JasonHEngineering/BLDC-driver-DRV8316-MT6835/README.md

# BLDC-driver-DRV8316-MT6835
Custom PCBA build BLDC driver based on DRV8316 and absolute encoder MT6835

WordPress:
https://jashuang1983.wordpress.com/custom-pcba-bldc-driver-esp32-c6-mini-drv8316-mt6835-sh65hvd/

YouTube:
https://youtu.be/7OfQm1vRN5s

Singled-sided PCBA design (larger, but would be more economical) - fabricated:





Double-sided PCBA design (smaller, but would be more expensive):
