JasonHEngineering/BLDC-driver-DRV8316-MT6835/BLDC_DRV8313_AS5048A_modular_trial/README.md

# Modular Trial DRV8313 + AS5048A 

Initial BLDC (GB2806) run based on DRV83163 module and absolute encoder AS5048A

Actual setup:



Equivalent setup:
