JasonHEngineering/BLDC-driver-DRV8316-MT6835/BLDC_DRV8316_MT6835_custom_board_double_side (not fabricated)/Production files/bom.csv

Designator | Footprint | Quantity | Value | LCSC Part #
C1, C9 | C1210 | 2 | 22uF ±10% 35V X5R 1210 | C6120016
C10, C11, C12 | C0402 | 3 | 1nF ±10% 50V X7R 0402 | C14442
C14 | C0402 | 1 | 10uF 6.3V X5R 0402 | C412251
C2, C26, C3, C32, C4, C5, C6, C7 | C0402 | 8 | 100nF ±10% 50V | C307331
C22, C28, C29, C8 | C0603 | 4 | 1uF ±10% 50V | C5199872
C23 | C0603 | 1 | 47nF ±10% 50V | C107093
C24 | CAP-SMD_BD5.0-L5.3-W5.3-LS6.0-FD-H5.4 | 1 | ±20% 35V 10uF SMD,D5xL4.5mm | C51953405
C25 | C0603 | 1 | 22uF ±20% 16V X5R 0603 | C2762594
D1, D2 | SOD-323_L1.8-W1.3-LS2.5-RD | 2 | CUS10S30,H3F | C146335
D3 | DFN1006-2L-BI | 1 | TPD1E10B06DPYR_C2937015 | C2937015
L2 | IND-SMD_L2.5-W2.0 | 1 | 10uH | C5832376
R1, R6 | R0402 | 2 | 100kΩ 62.5mW 50V | C60491
R10, R2, R3 | R0402 | 3 | 50V 62.5mW 100Ω ±1% 0402 | C106232
R11, R12, R15, R21, R22, R23, R24, R26 | R0402 | 8 | 62.5mW 50V ±1% 10kΩ 0402 | C60490
R13, R9 | R0402 | 2 | 5.1kΩ 62.5mW 50V | C105872
R16, R17, R18, R19, R27, R5 | R0402 | 6 | 62.5mW_50V_±1%_33Ω_0402 | C138002
R20 | R0402 | 1 | 120Ω 62.5mW 50V | C114758
R25 | R0805 | 1 | 125mW 22Ω ±1% 0805 | C107702
R4 | R0402 | 1 | 470Ω ±1% 62.5mW 0402 | C25117
R7 | R0805 | 1 | 19kΩ ±1% 125mW 0805 | C2930177
SW2, SW3 | SW-SMD_L3.9-W3.0-P4.45 | 2 | TS-1088-AR02016 | C720477
U1 | LED0603-R-RD | 1 | XL-1608UBC-06A | C7371904
U10 | WIFIM-SMD_61P-L16.6-W13.2-P0.80-ESP32-C6-MINI-1-N4 | 1 | ESP32-C6-MINI-1-H4 | C6553337
U11 | SOT-23-6_L2.9-W1.6-P0.95-LS2.8-BL | 1 | TP6841S6-A | C2844924
U2 | SOIC-8_L4.9-W3.9-P1.27-LS6.0-BL | 1 | SN65HVD230DR | C12084
U3 | SOT-23-6 | 1 | USBLC6-2SC6 | C7519
U4 | SOT-23-5_L2.9-W1.6-P0.95-LS2.8-BL | 1 | TLV75733PDBVR | C485517
U5 | TSSOP-16_L5.0-W4.4-P0.65-LS6.4-BL | 1 | MT6835GT-STD | C2932578
U7 | VQFN-40_L7.0-W5.0-P0.50-BL-EP5.7 | 1 | DRV8316CRRGFR | C5447274
U8, U9 | CONN-SMD_4P-P1.00_MEGASTAR_ZX-SH1.0-4PWT | 2 | ZX-SH1.0-4PWT | C7430446
USB2 | USB-TYPE-C-SMD_TYPE-C-16P-QTWT | 1 | TYPE-C 16P QTWT | C5187472
