JasonHEngineering/BLDC-driver-DRV8316-MT6835/BLDC_DRV8316_MT6835_custom_board_single_side (fabricated and tested)/README.md

# BLDC driver DRV8316, MT6835

Custom PCBA build BLDC driver based on DRV8316 and absolute encoder MT6835, which allows for driving a BLDC already. There is also a CAN transceiver SN65HVD230DR on board for conducting CAN communication.

Design notes for improvement:

1) The schematic would show that the MT6835 Vdd is connected to 5V. This is not healthy for SPI bus that are 3v3 intended. While in general the devices are working for now, I would need to note this in future iterations - Vdd should be powered with 3v3.

This is a slightly bigger version that was actually fabricated is also more economical due to 1-sided SMD assembly:



Soldering on 2 cables; 1 for the main power supply 8-24 V, and the other for the 3 phase BLDC 



Board with BLDC GB2806 mounted, along with a 6 mm diametric magnet mounted directly on motor shaft for position feedback 



The magnet is on the opposite of the MT6835 absolute encoder package, and is about 1 mm above the PCBA



3 boards connected over CAN bus. 2 of these boards have solder bridge (jumper) for CAN termination. 
