JasonHEngineering/BLDC-driver-DRV8316-MT6835/BLDC_DRV8316_MT6835_custom_board_double_side (not fabricated)/README.md

# BLDC driver DRV8316, MT6835

Custom PCBA build BLDC driver based on DRV8316 and absolute encoder MT6835

This is a double sided assembly version that is smaller than the single sided version:
