JasonHEngineering/BLDC-driver-DRV8316-MT6835/BLDC_DRV8316_MT6835_custom_board_single_side (fabricated and tested)/Test codes/CAN - Simple CAN transmitter and reciever pair/CAN message in Serial.png

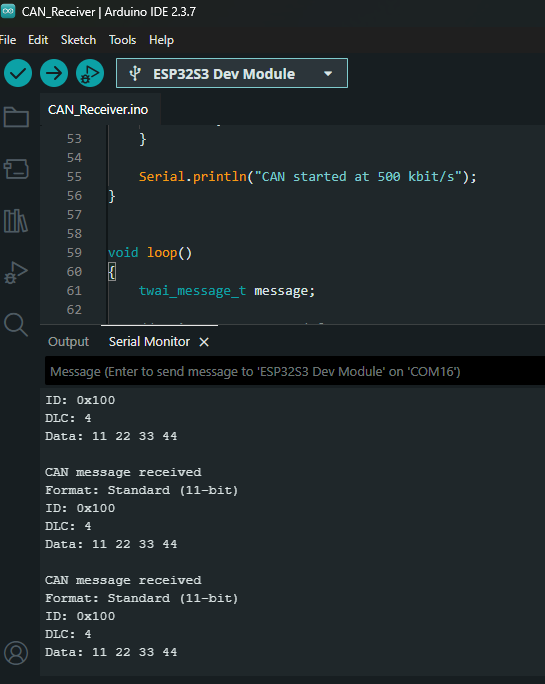
BLDC_DRV8316_MT6835_custom_board_single_side (fabricated and tested)/Test codes/CAN - Simple CAN transmitter and reciever pair/CAN message in Serial.png
