JasonHEngineering/BLDC-driver-DRV8316-MT6835/BLDC_DRV8316_MT6835_custom_board_double_side (not fabricated)/Schematic/ESP32-C6_DRV8316_MT6835_CAN_V1.pdf

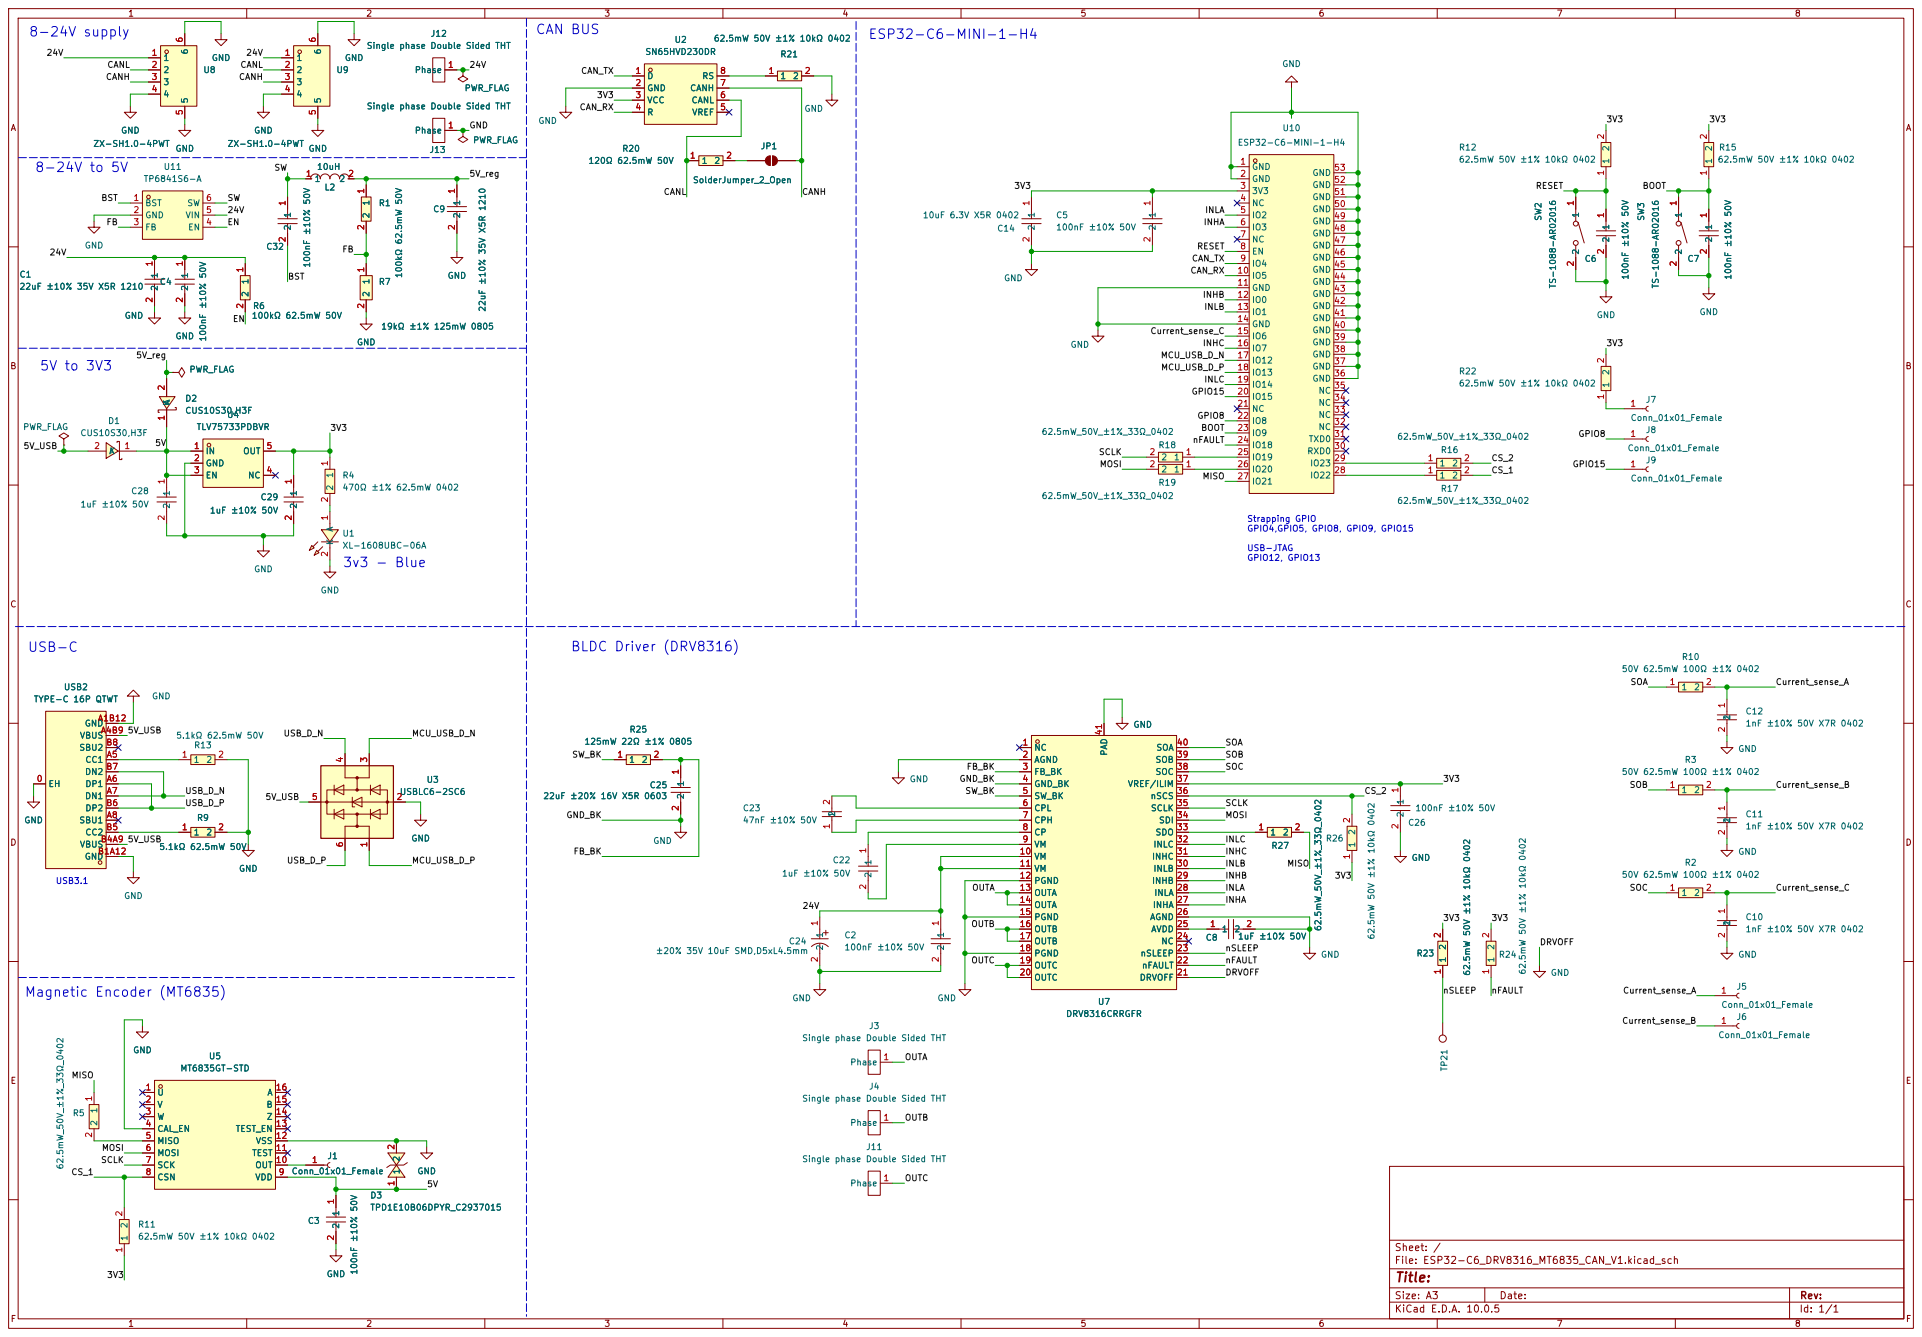
[picture p2: page 1]

Single phase Double Sided THT PWR_FLAG

Single phase Double Sided THT 1

Single phase Double Sided THT GND

OUTA

Single phase Double Sided THT

Size: A3 | Rev: | F Date:
KiCad E.D.A. 10.0.5 | Id: 1/1
