JasonHEngineering/BLDC-driver-DRV8316-MT6835/BLDC_DRV8316_MT6835_custom_board_single_side (fabricated and tested)/Schematic/ESP32-C6_DRV8316_MT6835_CAN_V2.pdf

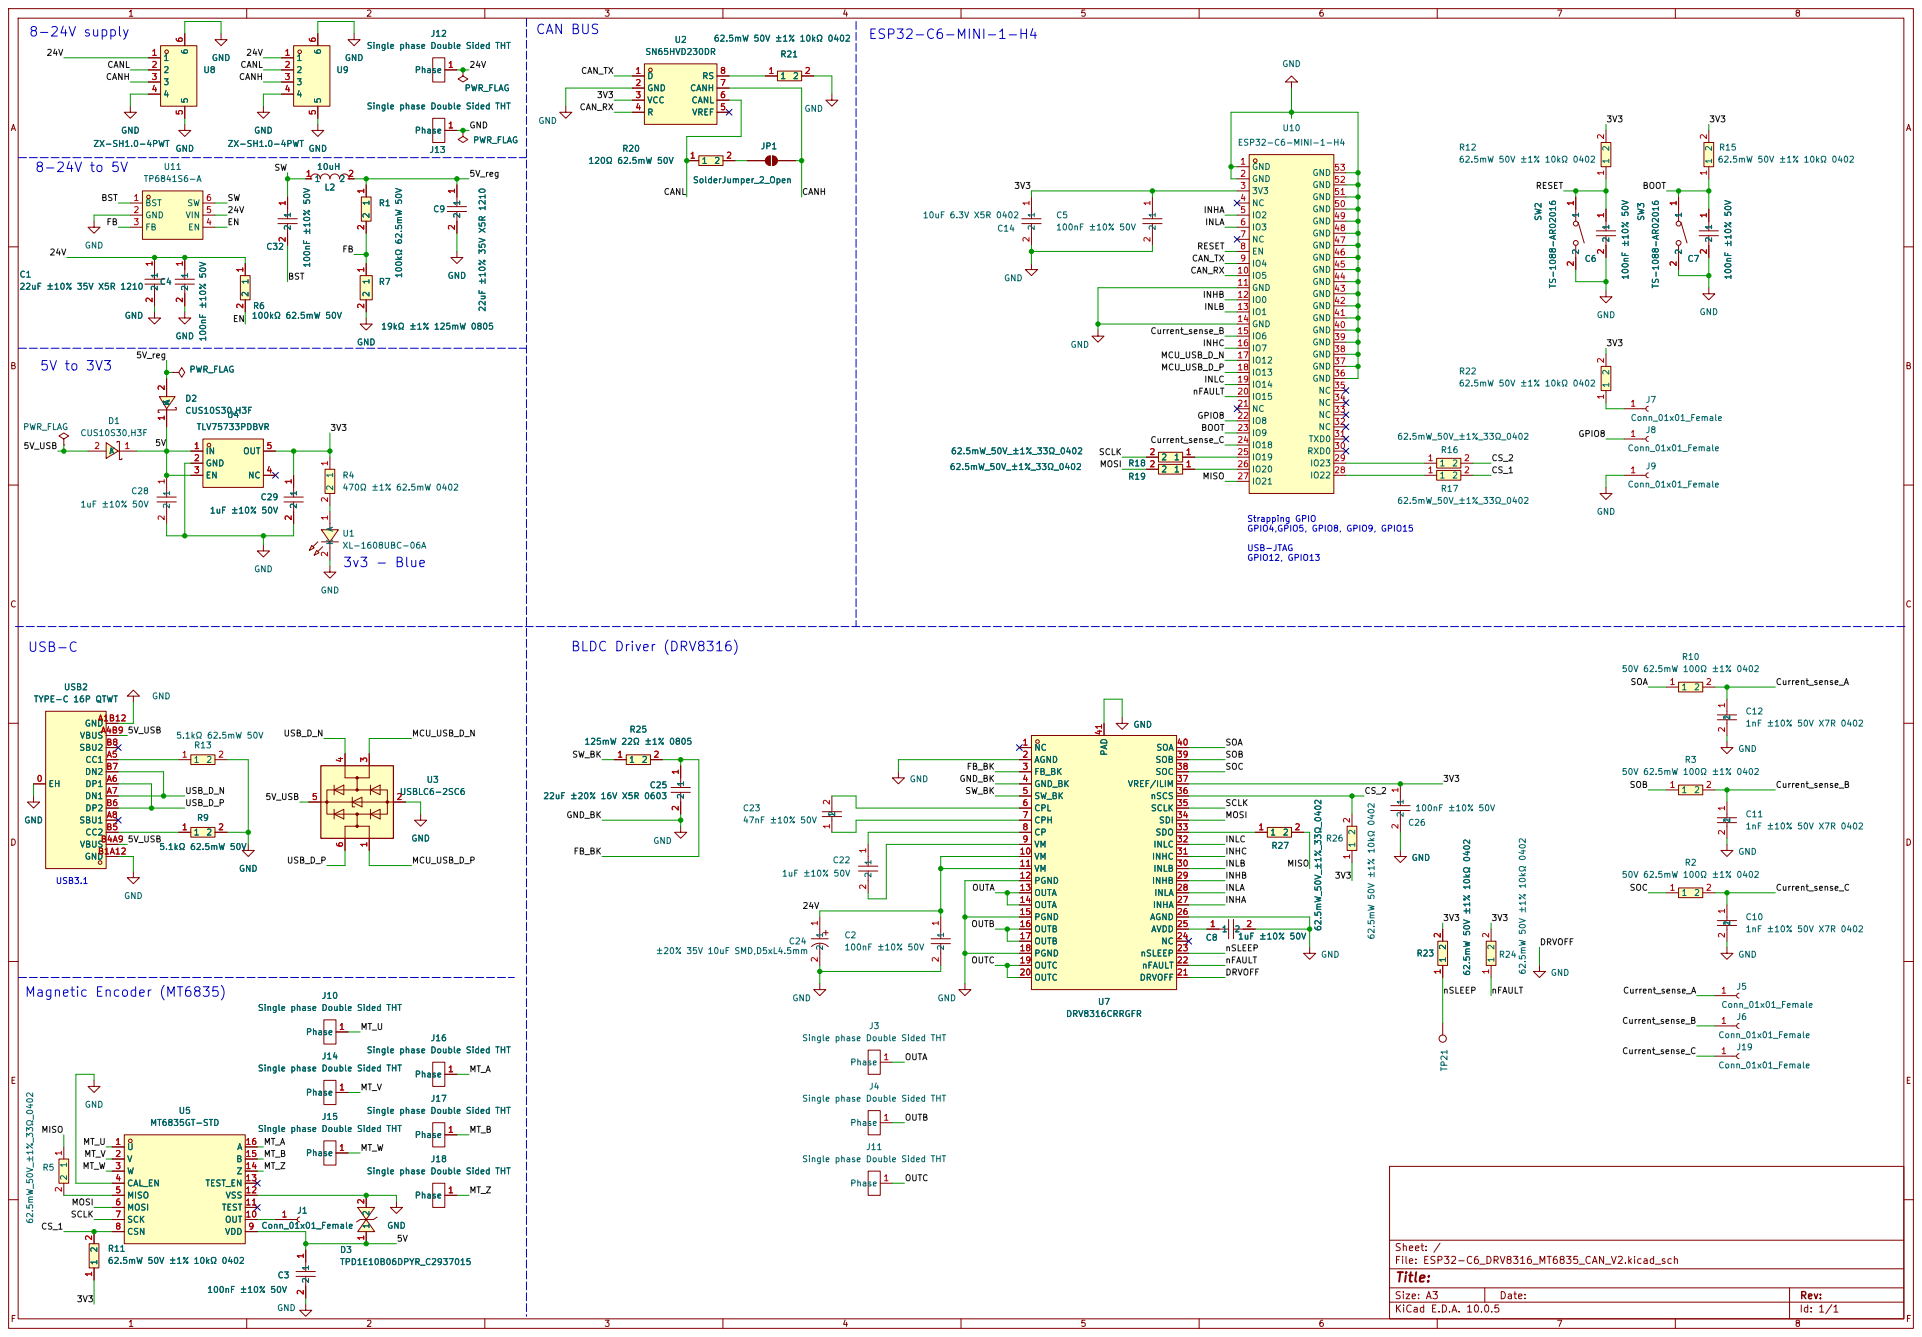
[picture p3: page 1]

Single phase Double Sided THT

Single phase Double Sided THT GND

Size: A3 | Rev: | F Date:
KiCad E.D.A. 10.0.5 | Id: 1/1
