JasonHEngineering/BLDC-driver-DRV8316-MT6835/(commit log)

2026-09-06 Initial Upload
    Initial Upload - folder creation
    [bom.csv, designators.csv, positions.csv]
2026-09-07 Update structure
    [bom.csv, designators.csv, positions.csv]
2026-10-30 Upload BLDC_can_speed_control_joystick
    Upload of BLDC_can_speed_control_joystick
2026-10-31 Upload of BLDC_websocket_position_control
    Upload of BLDC_websocket_position_control
